lgib2u/SHARKY/assets/exploded/sharky-core-module.png

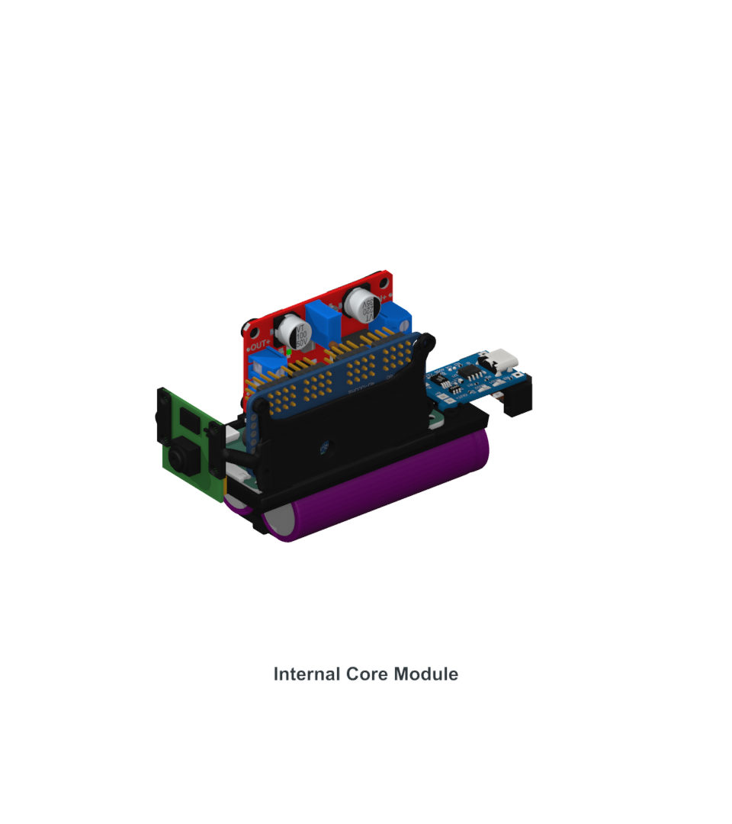
assets/exploded/sharky-core-module.png
