lgib2u/SHARKY/parts/stl/README.md

# SHARKY print files

These nine binary STL files are high-resolution exports from the full SHARKY
Fusion assembly. They are supplied in millimetres and contain the fabrication
bodies—not the simplified meshes previously used for visualisation.

The eye file contains both inserts. Print four copies each of the leg and
knuckle; print one of every other file.

| File | Quantity | Approximate bounding box (mm) |
| --- | ---: | ---: |
| `main-body.stl` | 1 | 120.71 × 104.50 × 63.91 |
| `internal-electronics-holder.stl` | 1 | 108.37 × 39.25 × 54.63 |
| `lid.stl` | 1 | 104.57 × 43.94 × 26.06 |
| `leg.stl` | 4 | 20.00 × 77.66 × 15.48 |
| `knuckle.stl` | 4 | 37.19 × 56.97 × 38.26 |
| `eye-inserts.stl` | 1 pair | 0.80 × 29.32 × 6.58 |
| `mouth-insert.stl` | 1 | 1.20 × 38.69 × 14.07 |
| `blow-hole.stl` | 1 | 13.14 × 13.14 × 5.50 |
| `rear-cover.stl` | 1 | 3.00 × 28.73 × 24.18 |

## Before printing

1. Confirm that the main body is approximately 121 mm long after import. If it is
   unexpectedly tiny or huge, set the slicer's import units to millimetres.
2. Choose a stable face and orient each part for your printer rather than
   assuming the exported CAD orientation is the ideal print orientation.
3. Preview every sliced layer and inspect thin walls, holes, bridges, and servo
   pockets.
4. Print a small fit test where practical. Servo cases, horns, screws, and
   printer calibration vary enough to affect assembly.

No universal material, support, wall, or infill setting is claimed: those
choices depend on the printer, material, payload, and intended gait testing.
