lgib2u/SHARKY/parts/stl/main-body.stl

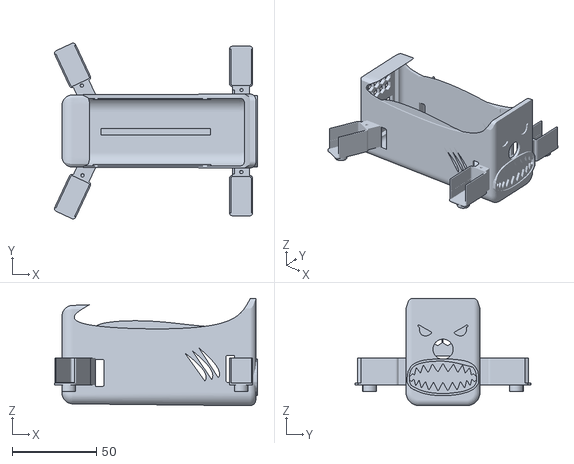
[picture p7: CAD file, 2026-10-16]
parts/stl/main-body.stl
120.7 x 104.5 x 63.9
