lgib2u/SHARKY/parts/stl/mouth-insert.stl

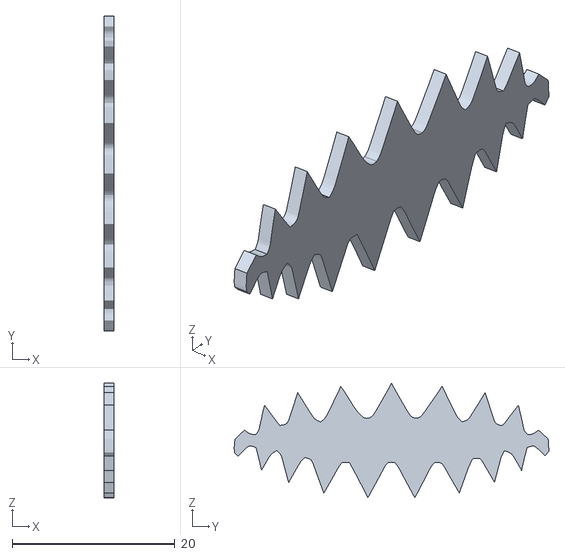
[picture p8: CAD file, 2026-10-16]
parts/stl/mouth-insert.stl
1.20 x 38.7 x 14.1
