lgib2u/SHARKY/parts/stl/rear-cover.stl

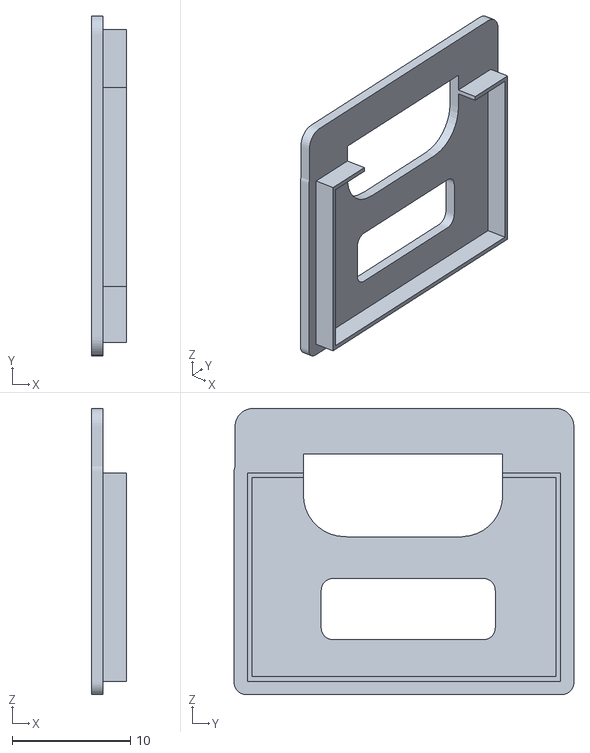
[picture p9: CAD file, 2026-10-16]
parts/stl/rear-cover.stl
3.00 x 28.7 x 24.2
