lgib2u/SHARKY/parts/stl/internal-electronics-holder.stl

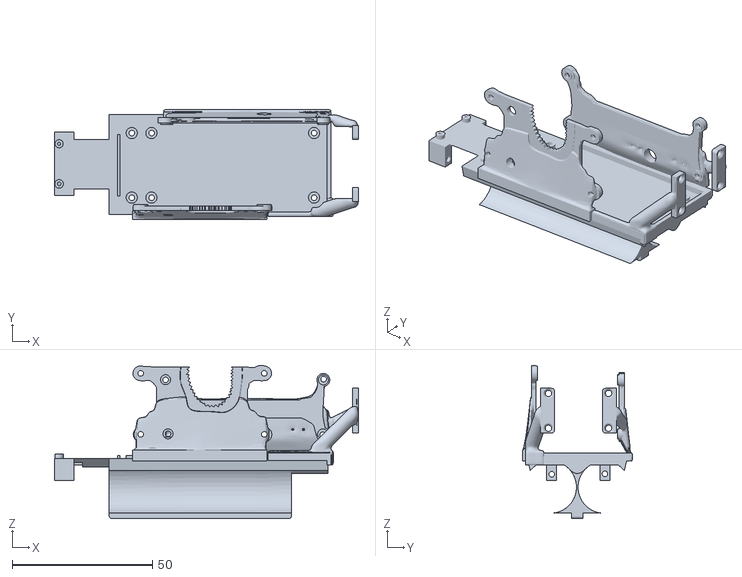
[picture p10: CAD file, 2026-10-16]
parts/stl/internal-electronics-holder.stl
108.4 x 39.2 x 54.6
