lgib2u/SHARKY/parts/stl/leg.stl

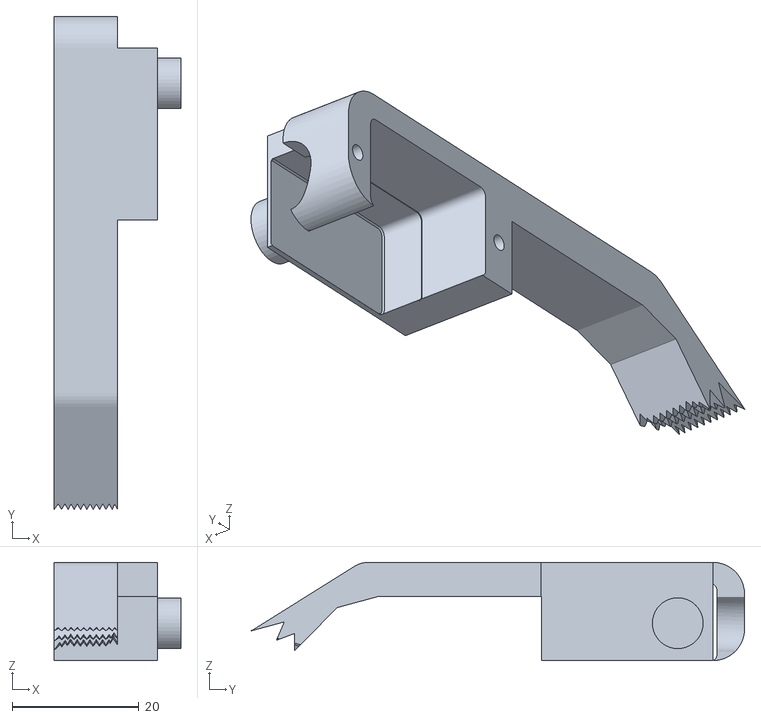
[picture p11: CAD file, 2026-10-16]
parts/stl/leg.stl
20.0 x 77.7 x 15.5
