lgib2u/SHARKY/parts/stl/lid.stl

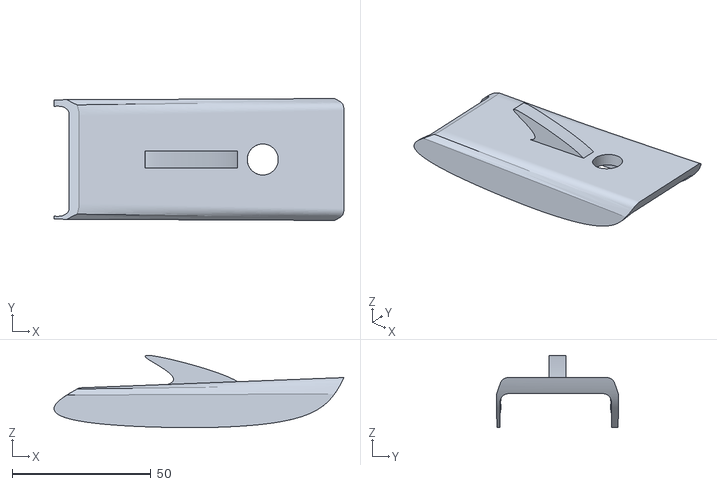
[picture p12: CAD file, 2026-10-16]
parts/stl/lid.stl
104.6 x 43.9 x 26.1
