lgib2u/SHARKY/parts/stl/knuckle.stl

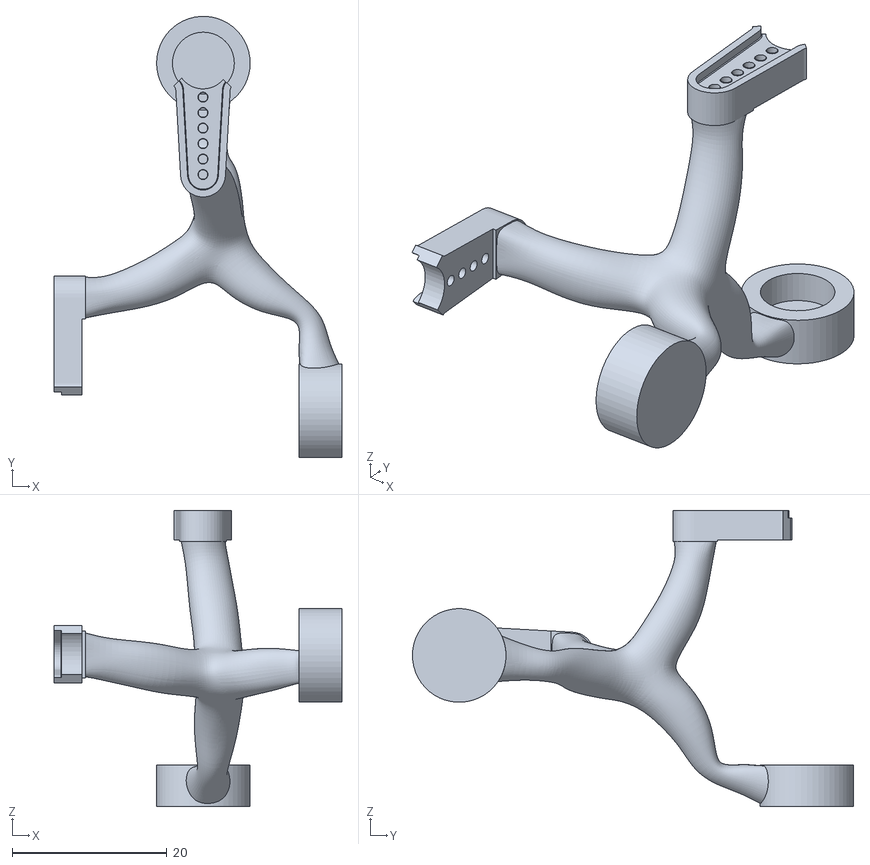
[picture p13: CAD file, 2026-10-16]
parts/stl/knuckle.stl
37.2 x 57.0 x 38.3
