lgib2u/SHARKY/parts/stl/eye-inserts.stl

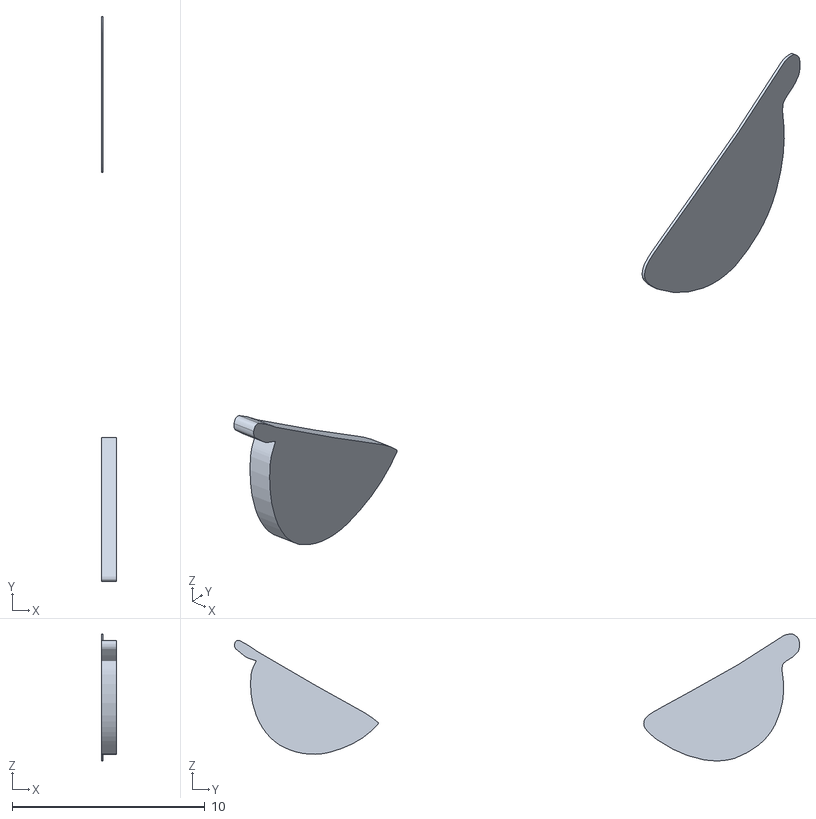
[picture p14: CAD file, 2026-10-16]
parts/stl/eye-inserts.stl
0.8 x 29.3 x 6.58
