lgib2u/SHARKY/parts/stl/blow-hole.stl

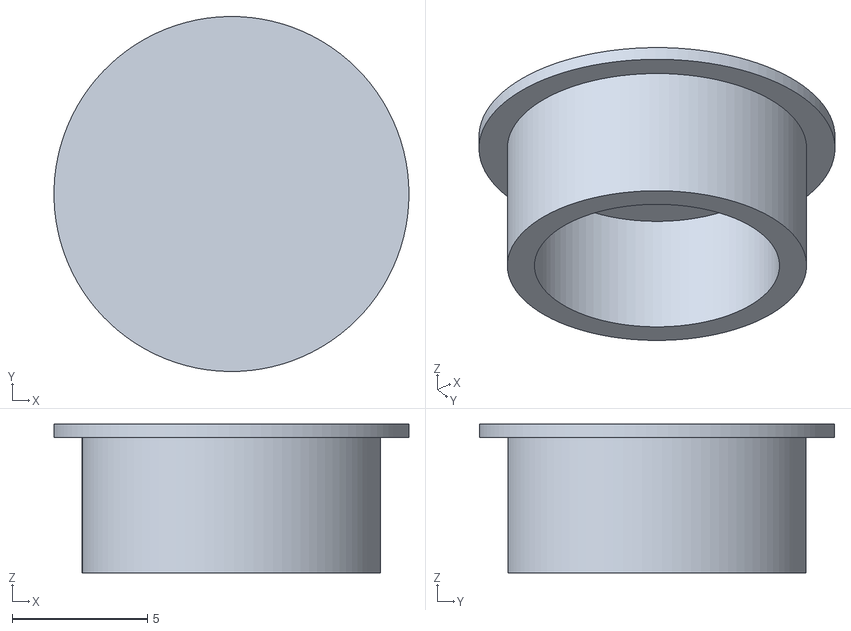
[picture p15: CAD file, 2026-10-16]
parts/stl/blow-hole.stl
13.1 x 13.1 x 5.50
