lgib2u/SHARKY/(commit log)

2026-10-16 Publish curated SHARKY hardware and software release
    [FootL1_1_1.stl, FootL2_1_1.stl, FootR1_1_1.stl, FootR2_1_1.stl, LegL1_1_1.stl, LegL2_1_1.stl, LegR1_1_1.stl, LegR2_1_1.stl]
2026-10-16 Replace URDF with print-ready STLs and transparent render
    [Quadruped.xacro, body.stl, front-left-foot.stl, front-left-leg.stl, front-right-foot.stl, front-right-leg.stl, materials.xacro, rear-left-foot.stl]
2026-10-16 Simplify landing page and add Raspberry Pi ROS 2 guide
2026-10-16 Replace visual meshes with Fusion print exports
    [blow-hole.stl, body.stl, eye-inserts.stl, front-left-foot.stl, front-left-leg.stl, front-right-foot.stl, front-right-leg.stl, internal-electronics-holder.stl]
2026-10-16 Remove landing page tagline
2026-10-16 Update hardware overview and add wiring diagram section
    Removed specific hardware components from the overview and added a placeholder for wiring diagram.
2026-10-16 Add SHARKY system and wiring diagrams
